Osmantsn/BMS-Battery-Emulator/Nextion/STOP.png

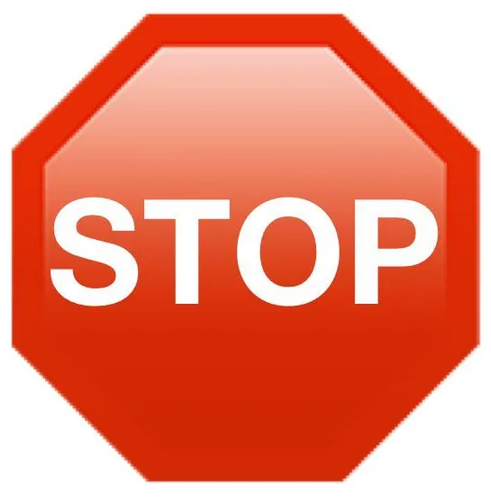
Nextion/STOP.png
