Osmantsn/BMS-Battery-Emulator/README.md

# BMS-Test-Battery-Emulator
Hardware-based battery emulator for safe BMS testing. ESP32-S3 host controls up to 4 cell boards via I²C (AD5282), reads voltage/current/temperature through a multiplexer (ADG706), and provides a simple GUI/control interface.
