Osmantsn/BMS-Battery-Emulator/Nextion/A.png

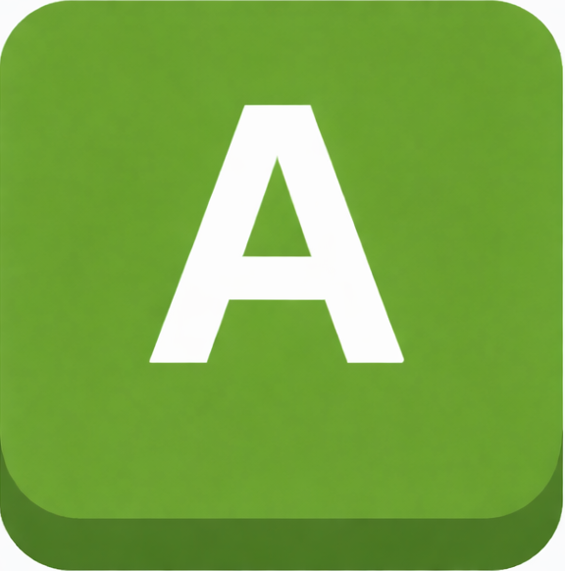
Nextion/A.png
