Osmantsn/BMS-Battery-Emulator/Nextion/A_pressed.png

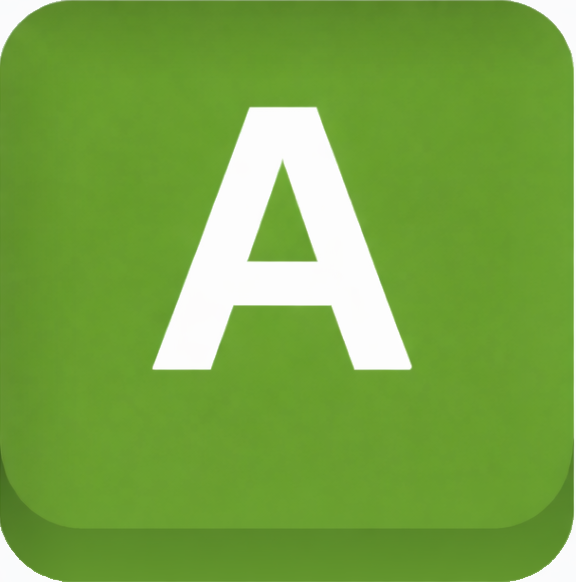
Nextion/A_pressed.png
