Osmantsn/BMS-Battery-Emulator/Nextion/apply.png

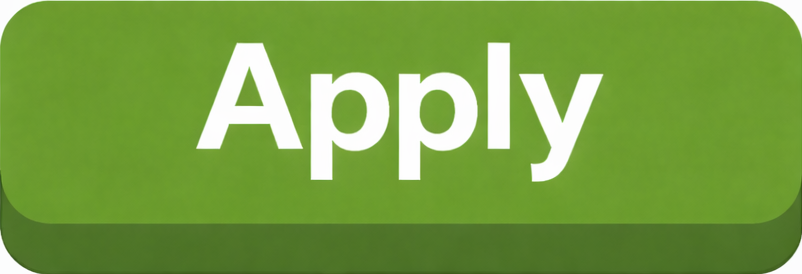
Nextion/apply.png
