Osmantsn/BMS-Battery-Emulator/Nextion/apply_pressed (1).png

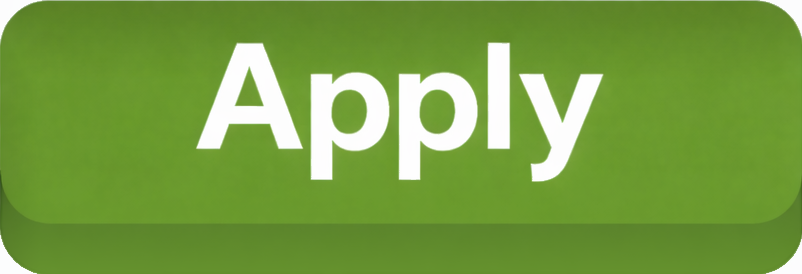
Nextion/apply_pressed (1).png
