Osmantsn/BMS-Battery-Emulator/Nextion/B.png

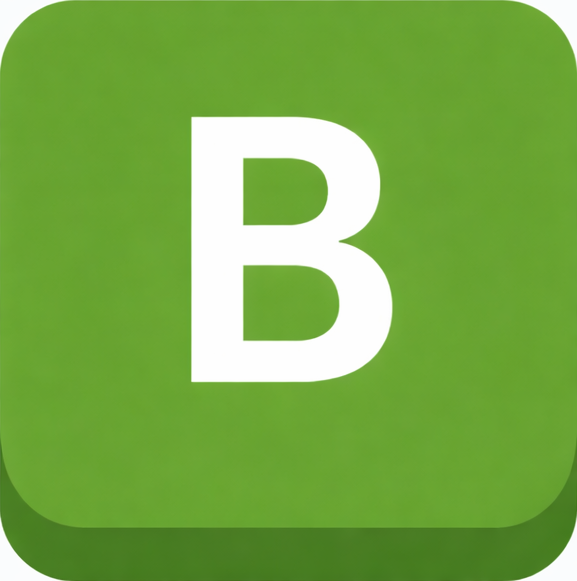
Nextion/B.png
