Osmantsn/BMS-Battery-Emulator/Nextion/battery.png

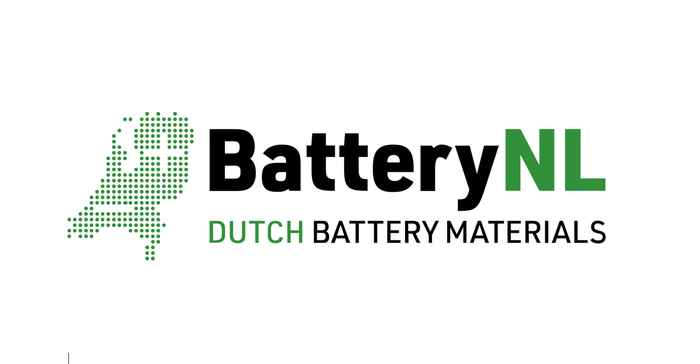
Nextion/battery.png
