Osmantsn/BMS-Battery-Emulator/Nextion/C.png

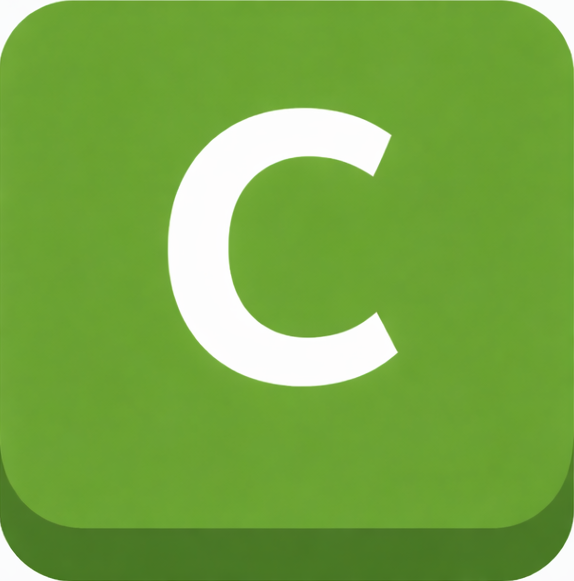
Nextion/C.png
