Osmantsn/BMS-Battery-Emulator/Nextion/d-balk.png

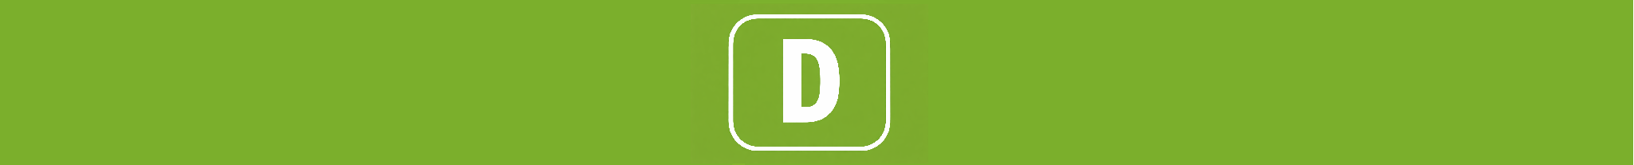
Nextion/d-balk.png
