Osmantsn/BMS-Battery-Emulator/Nextion/help.png

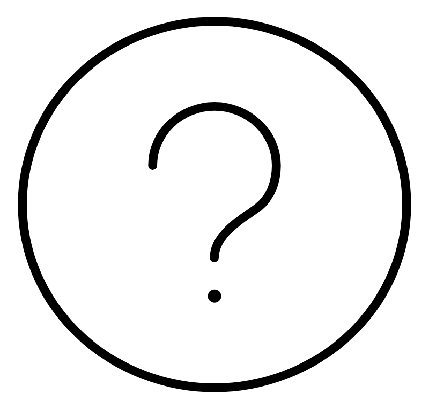
Nextion/help.png
