Osmantsn/BMS-Battery-Emulator/Nextion/left.png

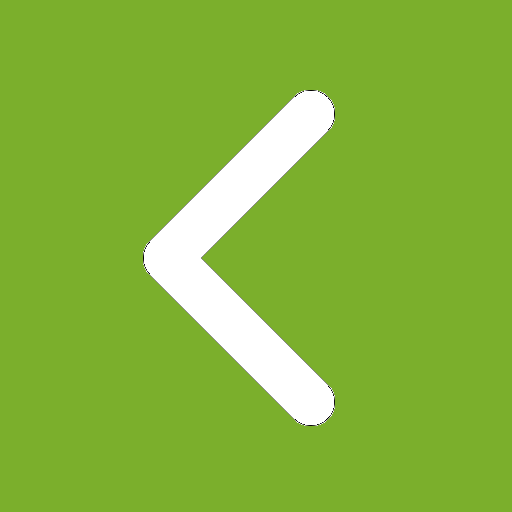
Nextion/left.png
