Osmantsn/BMS-Battery-Emulator/Nextion/right.png

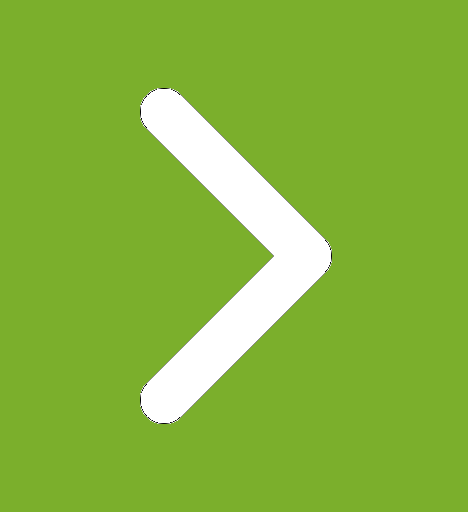
Nextion/right.png
