Osmantsn/BMS-Battery-Emulator/Nextion/stop_better2.png

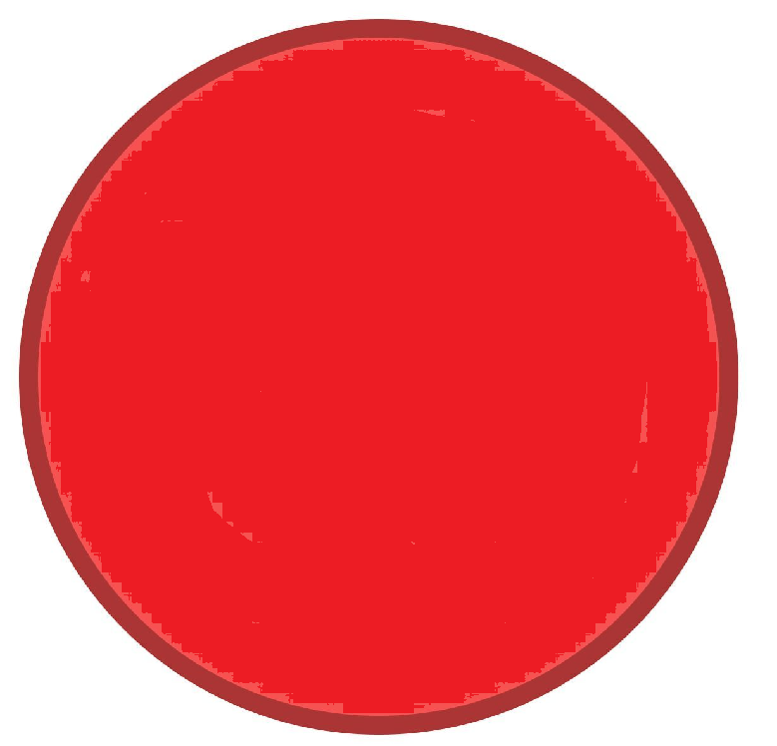
Nextion/stop_better2.png
