Osmantsn/BMS-Battery-Emulator/Nextion/stop_better.png

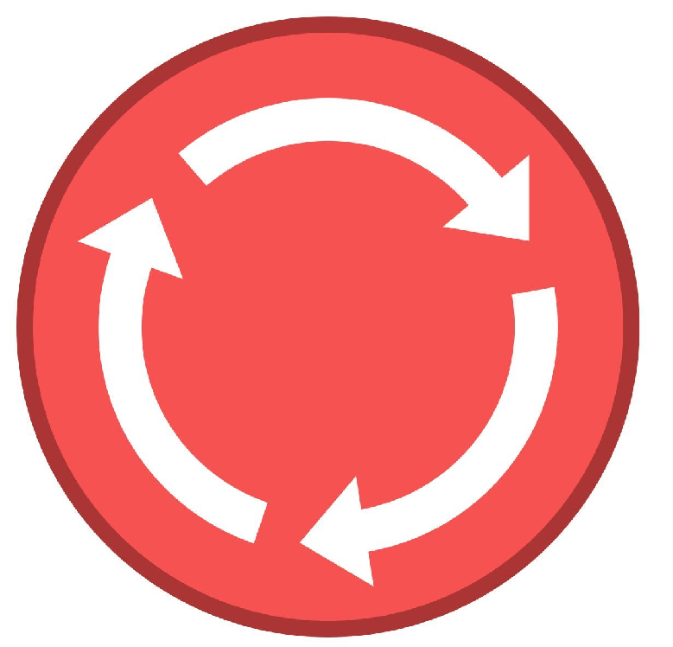
Nextion/stop_better.png
