Osmantsn/BMS-Battery-Emulator/BatterySystemHardware2025-2025/CAD/Case.step

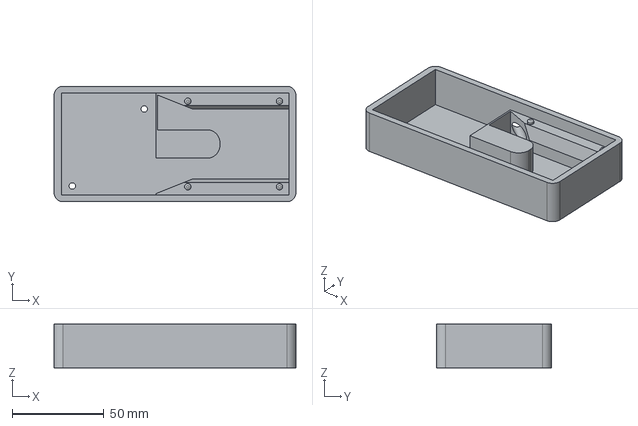
[picture p55: CAD file, 2026-01-04]
BatterySystemHardware2025-2025/CAD/Case.step
132.0 x 63.0 x 24.0 mm
