Osmantsn/BMS-Battery-Emulator/BatterySystemHardware2025-2025/CAD/PCB.step

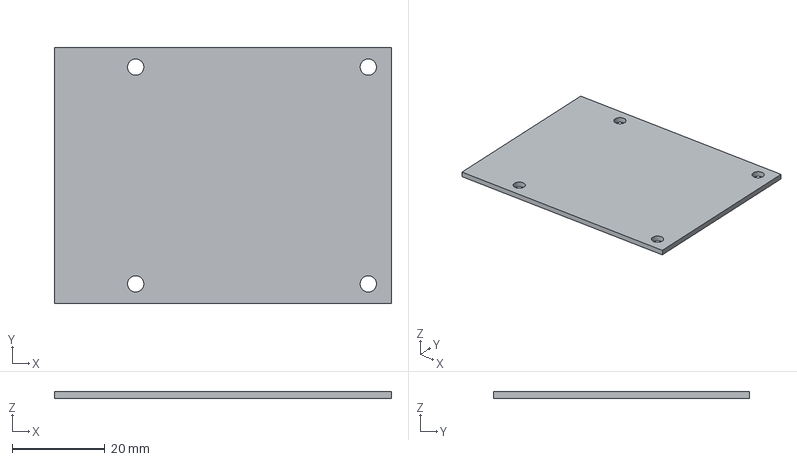
[picture p56: CAD file, 2026-01-04]
BatterySystemHardware2025-2025/CAD/PCB.step
72.5 x 55.0 x 1.50 mm
