Osmantsn/BMS-Battery-Emulator/(list of files, cad)

Other CAD files:
BatterySystemHardware2025-2025/CAD/Case.FCStd
BatterySystemHardware2025-2025/CAD/PCB.FCStd
