Osmantsn/BMS-Battery-Emulator/BatterySystemHardware2025-2025/PCB/Cell board (2025)/CellBoard/CellBoard.kicad_pcb

## KiCad design BatterySystemHardware2025-2025/PCB/Cell board (2025)/CellBoard/CellBoard.kicad_pcb (2026-01-04)

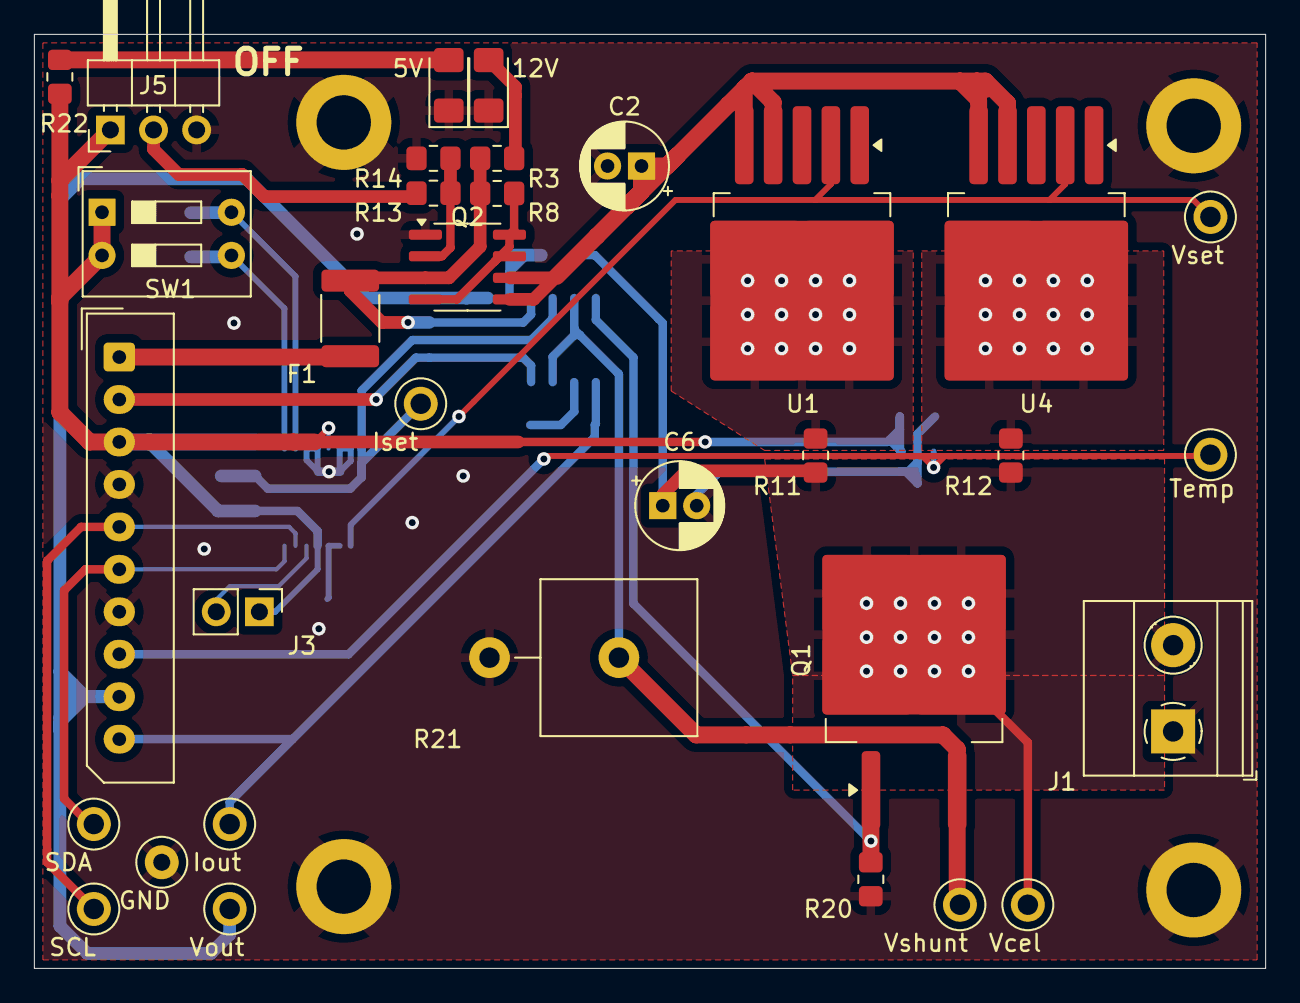
[picture p57: board CellBoard.kicad_pcb from above]

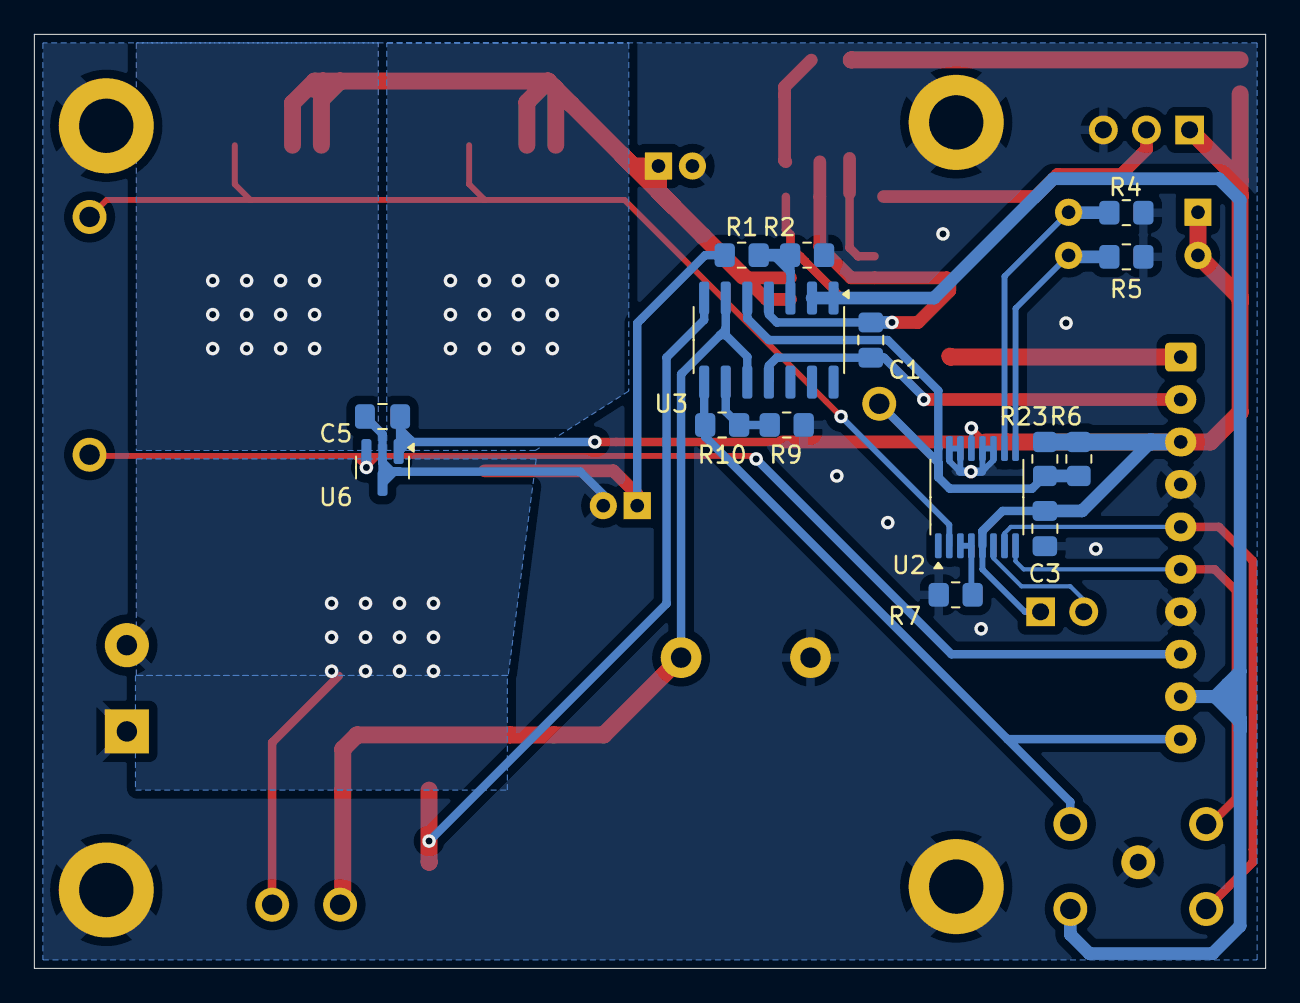
[picture p58: board CellBoard.kicad_pcb from below]

Board: 2 copper layers, 72.5 x 55.0 mm, 52 parts (15 on the bottom side), 29 nets.

Parts:
5V, 12V: LED; LED_1206_3216Metric_Pad1.42x1.75mm_HandSolder
C1, C3, C5: 100n; C_0805_2012Metric_Pad1.18x1.45mm_HandSolder
C2: 1u; CP_Radial_D5.0mm_P2.00mm
C6: 10u; CP_Radial_D5.0mm_P2.00mm
F1: 1812L200/12DR; Fuse_1812_4532Metric_Pad1.30x3.40mm_HandSolder
GND: TestPoint; TestPoint_Loop_D2.50mm_Drill1.0mm
H5, H6, H7, H8: MountingHole_Pad; MountingHole_3.2mm_M3_DIN965_Pad
Iout: TestPoint; TestPoint_Loop_D2.50mm_Drill1.0mm
Iset: TestPoint; TestPoint_Loop_D2.50mm_Drill1.0mm
J1: Screw_Terminal_01x02; TerminalBlock_Phoenix_MKDS-1,5-2-5.08_1x02_P5.08mm_Horizont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
J2: Conn_01x10_Pin; Molex_SPOX_5267-10A_1x10_P2.50mm_Vertical
J3: Conn_01x02_Pin; PinHeader_1x02_P2.54mm_Vertical
J5: Conn_01x03_Pin; PinHeader_1x03_P2.54mm_Horizontal
Q1: IRFS4115; TO-263-2
Q2: FDS4897C; SOIC-8_3.9x4.9mm_P1.27mm
R1: 1k2; R_0805_2012Metric_Pad1.20x1.40mm_HandSolder
R2: 2k7; R_0805_2012Metric_Pad1.20x1.40mm_HandSolder
R3: 390; R_0805_2012Metric_Pad1.20x1.40mm_HandSolder
R4, R5, R9, R13: 1k; R_0805_2012Metric_Pad1.20x1.40mm_HandSolder
R6, R23: 1M2; R_0805_2012Metric_Pad1.20x1.40mm_HandSolder
R7: 39k; R_0805_2012Metric_Pad1.20x1.40mm_HandSolder
R8, R14, R20: 10k; R_0805_2012Metric_Pad1.20x1.40mm_HandSolder
R10: 2k2; R_0805_2012Metric_Pad1.20x1.40mm_HandSolder
R11, R12: 10m; R_0805_2012Metric_Pad1.20x1.40mm_HandSolder
R21: 0.5; R_Axial_Power_L25.0mm_W9.0mm_P7.62mm_Vertical
R22: 120; R_0805_2012Metric_Pad1.20x1.40mm_HandSolder
SCL: TestPoint; TestPoint_Loop_D2.50mm_Drill1.0mm
SDA: TestPoint; TestPoint_Loop_D2.50mm_Drill1.0mm
SW1: BSE02GR; SW_DIP_SPSTx02_Slide_9.78x7.26mm_W7.62mm_P2.54mm
Temp: TestPoint; TestPoint_Loop_D2.50mm_Drill1.0mm
U1, U4: LT3080xQ; TO-263-5_TabPin3
U2: AD5282; TSSOP-16_4.4x5mm_P0.65mm
U3: TL084; SO-14_3.9x8.65mm_P1.27mm
U6: MCP9700Ax-ETT; SOT-23
Vcel: TestPoint; TestPoint_Loop_D2.50mm_Drill1.0mm
Vout: TestPoint; TestPoint_Loop_D2.50mm_Drill1.0mm
Vset: TestPoint; TestPoint_Loop_D2.50mm_Drill1.0mm
Vshunt: TestPoint; TestPoint_Loop_D2.50mm_Drill1.0mm

Connections:
+5V: C3.1, C5.1, J2.3, J3.1, J5.1, R6.2, R22.2, R23.2, SW1.1, SW1.2, U2.5 (VDD), U2.13 (VLOG), U6.1 (V_{DD})
+12V: C1.1, F1.1, Q2.3 (1), R3.2, R8.2, U3.4 (V+)
-12V: C1.2, J2.2, U3.11 (V-)
/A0: R5.2, SW1.3, U2.9 (AD0)
/A1: R4.2, SW1.4, U2.10 (AD1)
/VcontrolledOut: C6.1, J1.2, Q1.2 (D), R1.1, R11.2, R12.2, Vcel.1
/vShunt: Q1.3 (S), R21.1, U3.6 (-), U3.10 (+), Vshunt.1
CurrentController: Iout.1, J2.10, R10.2, U3.8
GND: 5V.1 (K), 12V.1 (K), C2.2, C3.2, C5.2, C6.2, GND.1, H5.1, H6.1, H7.1, H8.1, J1.1, J2.4, J2.7, J5.3, Q2.1 (S), R2.2, R4.1, R5.1, R7.1, R9.2, R14.2, R20.2, R21.2, U2.11 (GND), U2.12 (VSS), U2.14 (B2), U2.15 (W2), U6.3 (GND)
I2C_SCL: J2.5, SCL.1, U2.7 (SCL)
I2C_SDA: J2.6, SDA.1, U2.8 (SDA)
unnamed: 12V.2 (A), R3.1
unnamed: 5V.2 (A), R22.1
unnamed: F1.2, J2.1
unnamed: J3.2, U2.6 (~SHDN)
unnamed: J5.2, R13.1
unnamed: Q1.1 (G), R20.1, U3.7
unnamed: Q2.2 (G), R13.2, R14.1
unnamed: Q2.4 (G), Q2.7 (D), Q2.8 (D), R8.1
unnamed: R11.1, U1.3 (OUT)
unnamed: R12.1, U4.3 (OUT)
unnamed: C2.1, Q2.5 (D), Q2.6 (D), U1.4 (V_{CONTROL}), U1.5 (IN), U4.4 (V_{CONTROL}), U4.5 (IN)
unnamed: U1.2 (SET), U2.2 (A1), U4.2 (SET), Vset.1
unnamed: Iset.1, R6.1, R23.1, U2.16 (A2), U3.5 (+)
unnamed: R7.2, U2.3 (W1), U2.4 (B1)
unnamed: R1.2, R2.1, U3.3 (+)
unnamed: R9.1, R10.1, U3.9 (-)
TempCell: J2.8, Temp.1, U6.2 (V_{OUT})
VoltageController: J2.9, U3.1, U3.2 (-), Vout.1
